willemcvu/gCAN-gauge/README.md

# gCAN-gauge
An open-source ESP32-based programmable digital gauge targeted at EV conversions

See some previews of mechanical stuff and BOM costing here: https://imgur.com/gallery/dh8G9dV/comment/2116424201
