willemcvu/gCAN-gauge/hardware/enclosure/Back Enclosure.stl

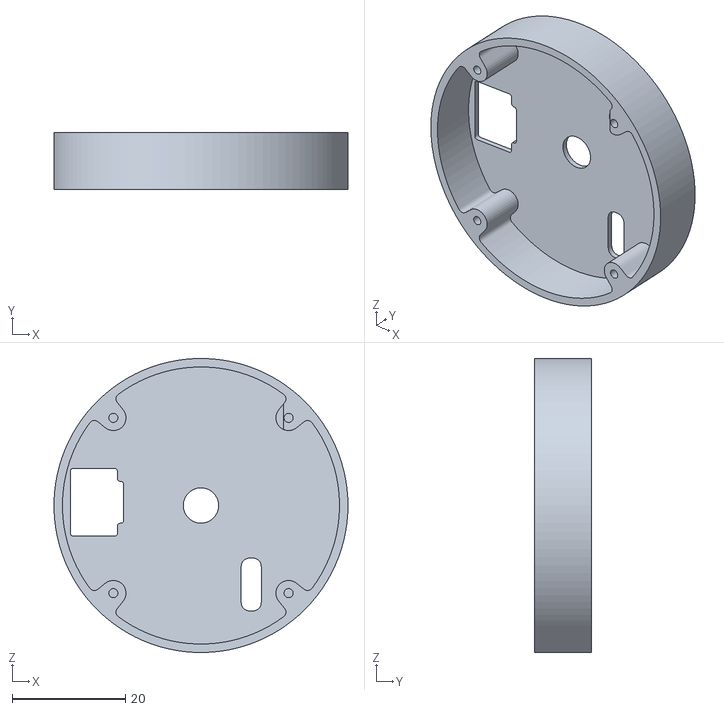
[picture p1: CAD file, 2021-08-13]
hardware/enclosure/Back Enclosure.stl
52.0 x 10.0 x 52.0
