willemcvu/gCAN-gauge/hardware/main-board/3d_models/PTS810SJS250SMTRLFS.stp

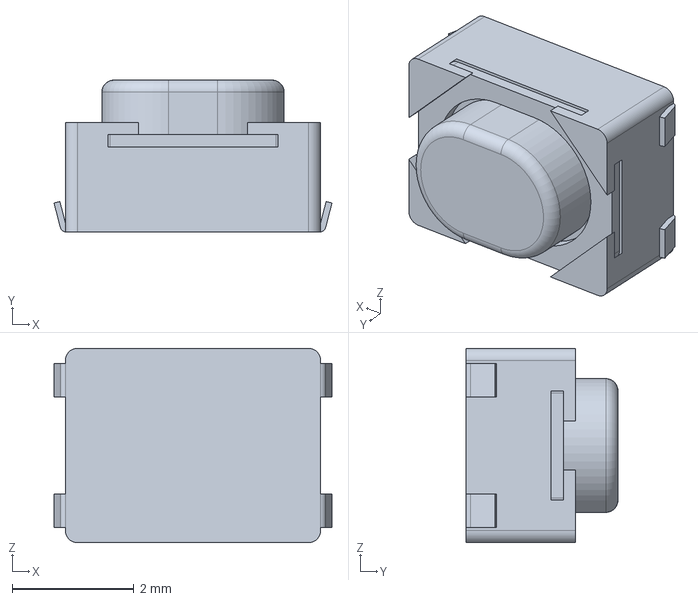
[picture p2: CAD file, 2021-08-01]
hardware/main-board/3d_models/PTS810SJS250SMTRLFS.stp
4.58 x 2.50 x 3.20 mm
