willemcvu/gCAN-gauge/hardware/enclosure/Front Enclosure.stl

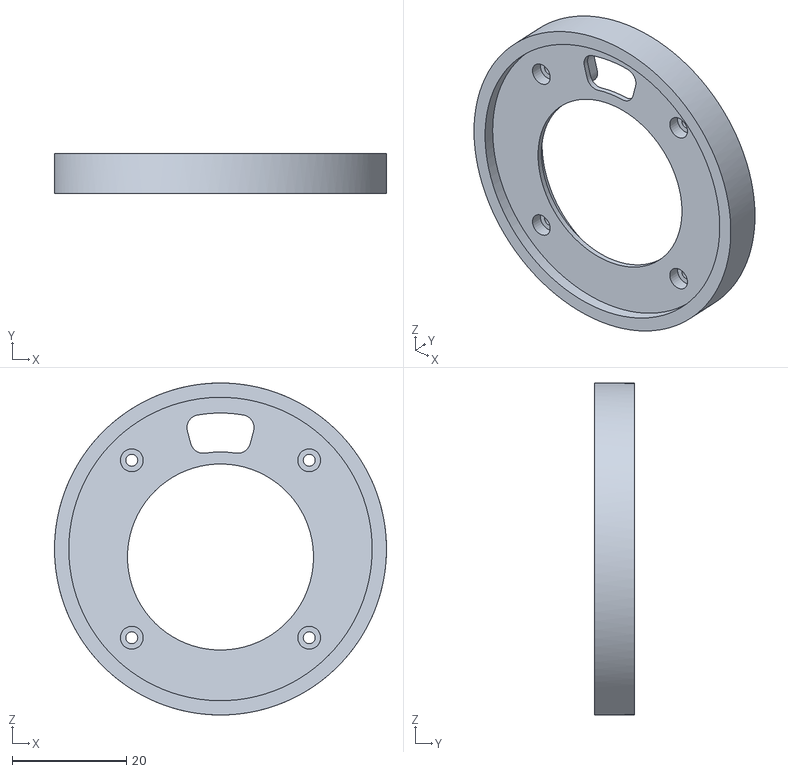
[picture p3: CAD file, 2021-08-13]
hardware/enclosure/Front Enclosure.stl
58.0 x 7.00 x 58.0
