willemcvu/gCAN-gauge/hardware/main-board/3d_models/B3S_110[].step

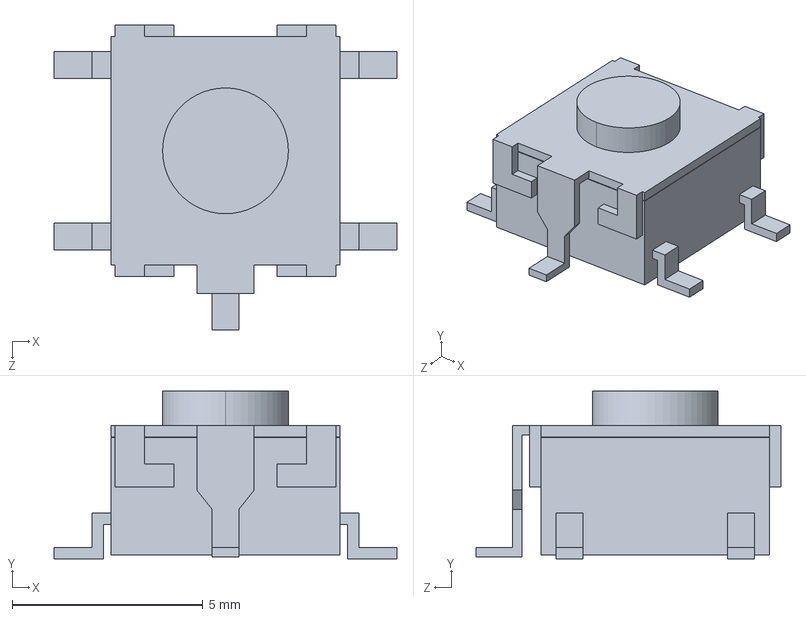
[picture p4: CAD file, 2021-08-01]
hardware/main-board/3d_models/B3S_110[].step
9.00 x 4.40 x 8.00 mm
