willemcvu/gCAN-gauge/hardware/enclosure/Front button.stl

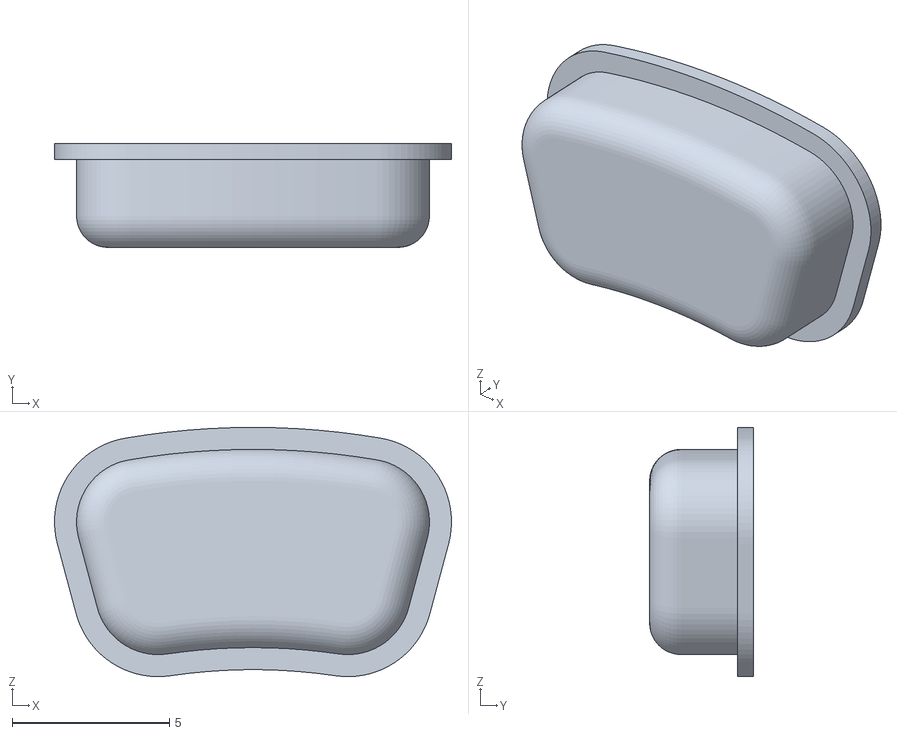
[picture p5: CAD file, 2021-08-13]
hardware/enclosure/Front button.stl
12.6 x 3.30 x 7.92
