willemcvu/gCAN-gauge/hardware/main-board/3d_models/SOP-8L_DIO.step

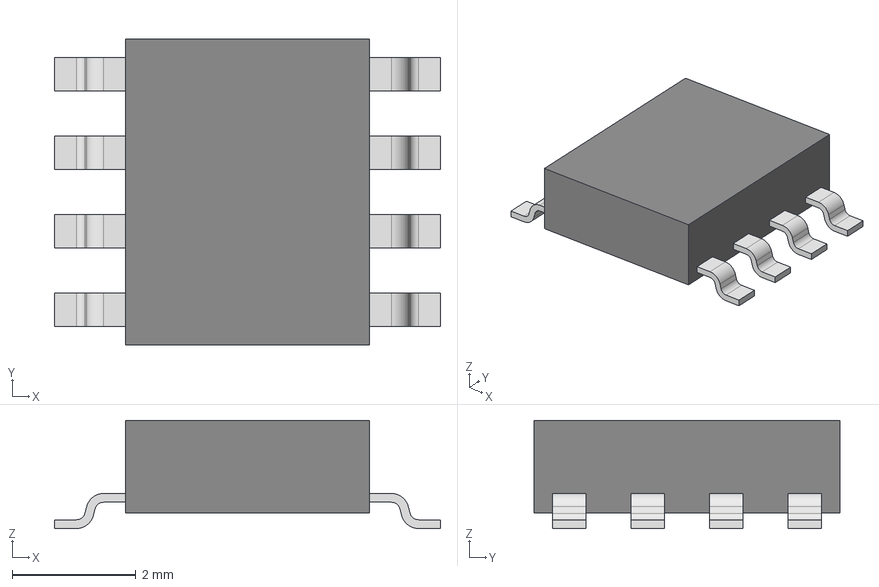
[picture p6: CAD file, 2021-07-31]
hardware/main-board/3d_models/SOP-8L_DIO.step
6.25 x 4.95 x 1.75 mm
