willemcvu/gCAN-gauge/hardware/main-board/3d_models/IND_TAIYO_NR6045_TAY.step

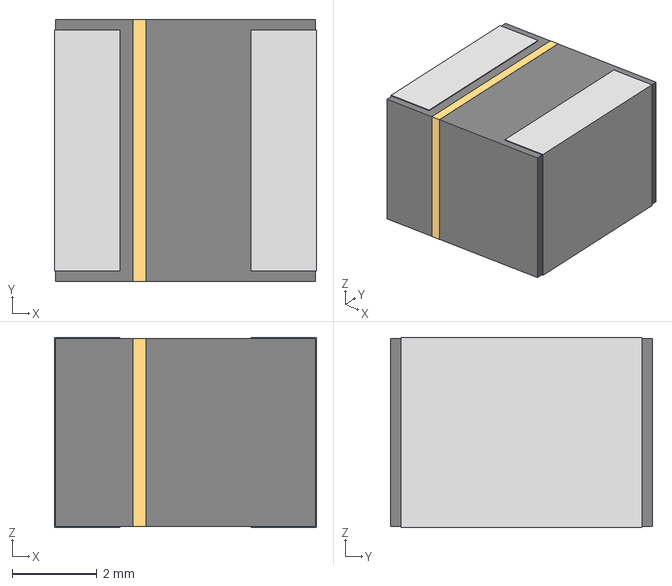
[picture p7: CAD file, 2021-07-31]
hardware/main-board/3d_models/IND_TAIYO_NR6045_TAY.step
6.20 x 6.20 x 4.50 mm
