willemcvu/gCAN-gauge/hardware/main-board/3d_models/B04B-JWPF-SK-R.STEP

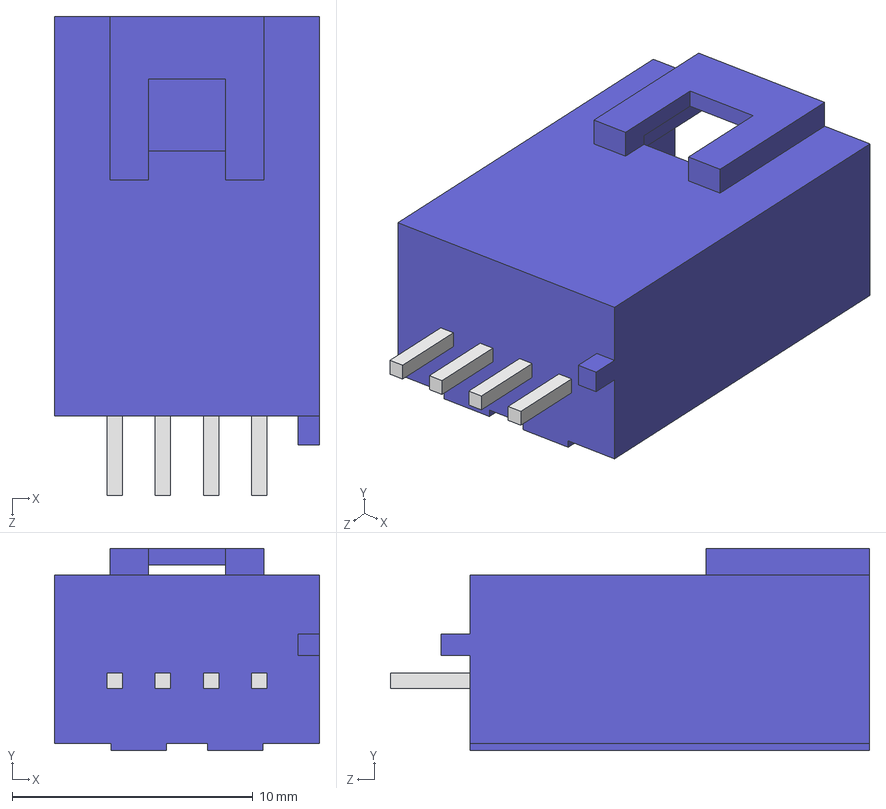
[picture p8: CAD file, 2021-07-31]
hardware/main-board/3d_models/B04B-JWPF-SK-R.STEP
11.0 x 8.40 x 19.9 mm
