willemcvu/gCAN-gauge/hardware/main-board/3d_models/K3D-DX07S024WJ3-V2_JAE_Proprietary.STEP

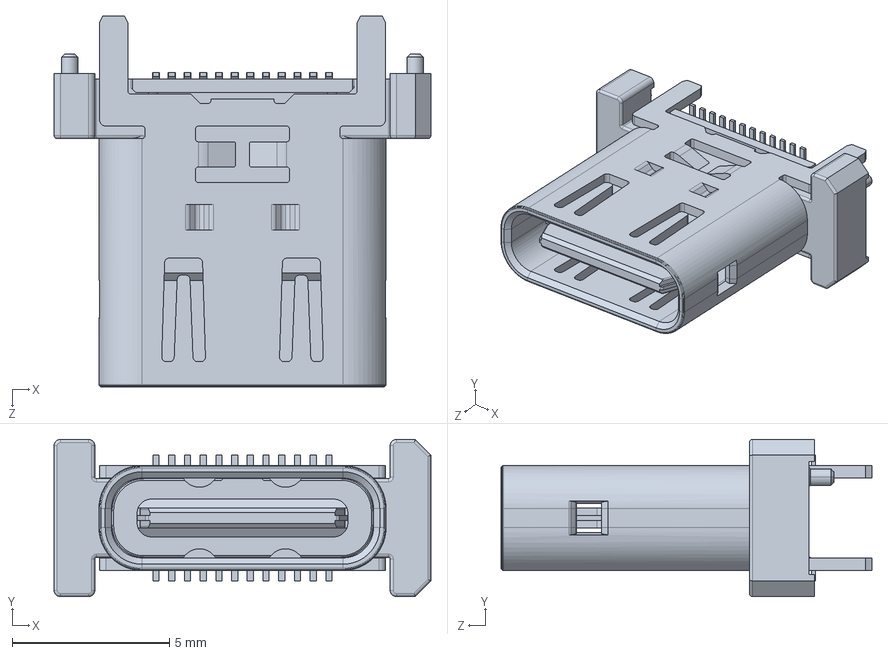
[picture p9: CAD file, 2021-07-31]
hardware/main-board/3d_models/K3D-DX07S024WJ3-V2_JAE_Proprietary.STEP
12.0 x 5.00 x 11.8 mm
