willemcvu/gCAN-gauge/hardware/main-board/3d_models/dr331.stp

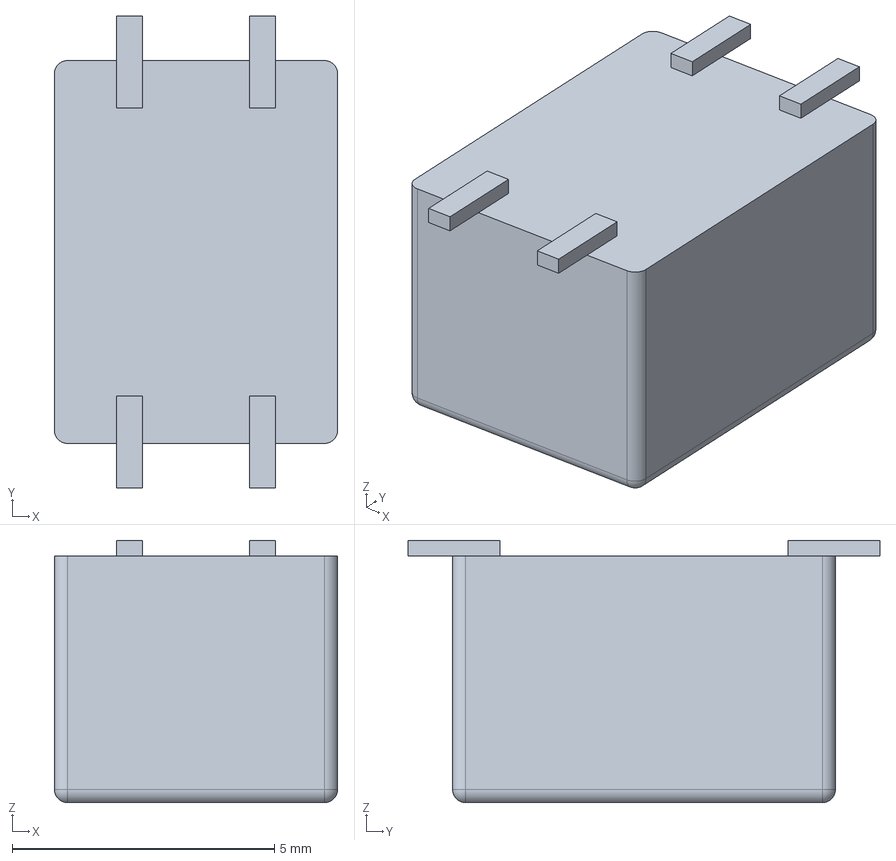
[picture p10: CAD file, 2021-07-23]
hardware/main-board/3d_models/dr331.stp
5.40 x 9.00 x 5.00 mm
