willemcvu/gCAN-gauge/(list of files, cad)

Other CAD files:
hardware/enclosure/gcan-gauge v31.f3z
