willemcvu/gCAN-gauge/hardware/main-board/main-board.kicad_pcb

## KiCad design hardware/main-board/main-board.kicad_pcb (2021-08-06)

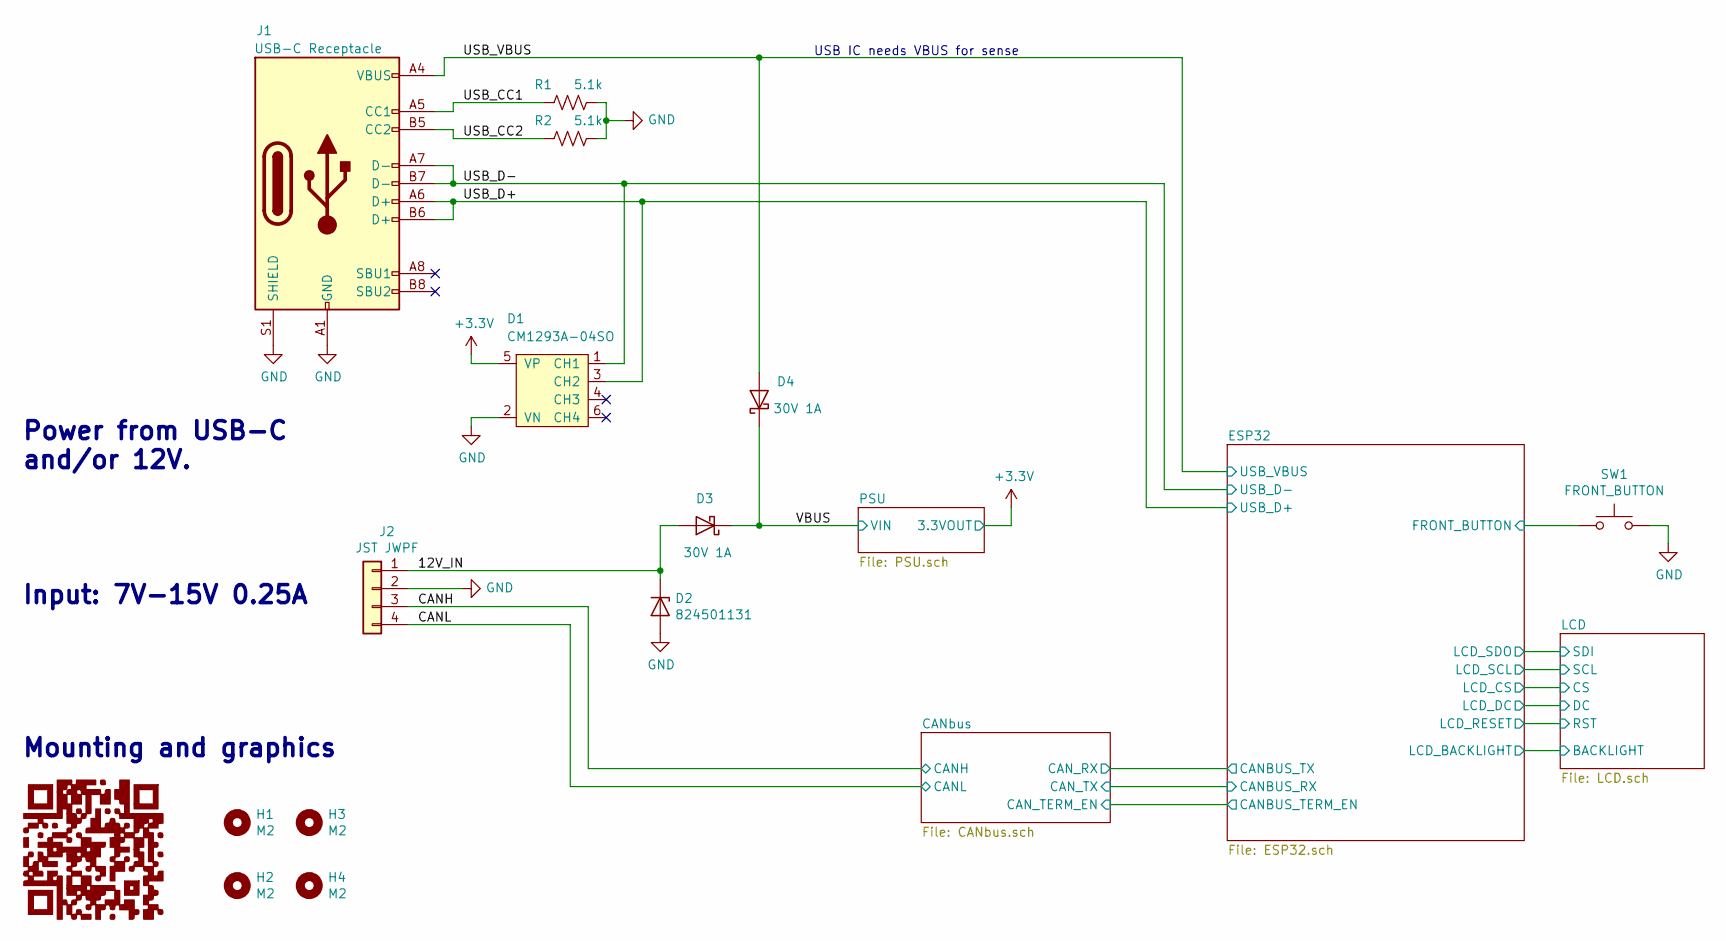
[picture p11: schematic main-board.sch]

Parts:
D1: CM1293A-04SO; SOT-23-6; MPN CM1293A-04SO
D2: 824501131; D_SMA; MPN 824501131
D3, D4: 30V 1A; D_SMA; MPN SS13MHRSG
G1: LOGO; gcan-gauge-github-link-qr; MPN DNP
H1, H2, H3, H4: M2; MountingHole_2.1mm; MPN DNP
J1: USB-C Receptacle; USB_C_Receptacle_JAE_DX07S024WJ3R400; MPN DX07S024WJ3R400
J2: JST JWPF; JST_JWPF_B04B-JWPF-SK-R_1x04_P2.00mm_Vertical; MPN B04B-JWPF-SK-R(LF)(SN)
R1, R2: 5.1k; R_0603_1608Metric; MPN RC0603JR-075K1L
SW1: FRONT_BUTTON; SW_SPST_PTS810; MPN B3S-1100P

Connections:
+3V3: D1.5 (VP); also elsewhere on the board
/12V_IN: D2.1 (K), D3.2 (A), J2.1
/CANH: J2.3; also elsewhere on the board
/CANL: J2.4; also elsewhere on the board
/ESP32/FRONT_BUTTON: SW1.1; also elsewhere on the board
/USB_CC1: J1.A5 (CC1), R1.2
/USB_CC2: J1.B5 (CC2), R2.2
/USB_D+: D1.3 (CH2), J1.A6 (D+), J1.B6 (D+); also elsewhere on the board
/USB_D-: D1.1 (CH1), J1.A7 (D-), J1.B7 (D-); also elsewhere on the board
/USB_VBUS: D4.2 (A), J1.A4 (VBUS), J1.A9 (VBUS), J1.B4 (VBUS), J1.B9 (VBUS); also elsewhere on the board
/VBUS: D3.1 (K), D4.1 (K); also elsewhere on the board
GND: D1.2 (VN), D2.2 (A), J1.A1 (GND), J1.A12 (GND), J1.B1 (GND), J1.B12 (GND), J1.S1 (SHIELD), J2.2, R1.1, R2.1, SW1.2; also elsewhere on the board

Notes on the sheet:
Input: 7V-15V 0.25A
Power from USB-C and/or 12V.
Mounting and graphics
USB IC needs VBUS for sense

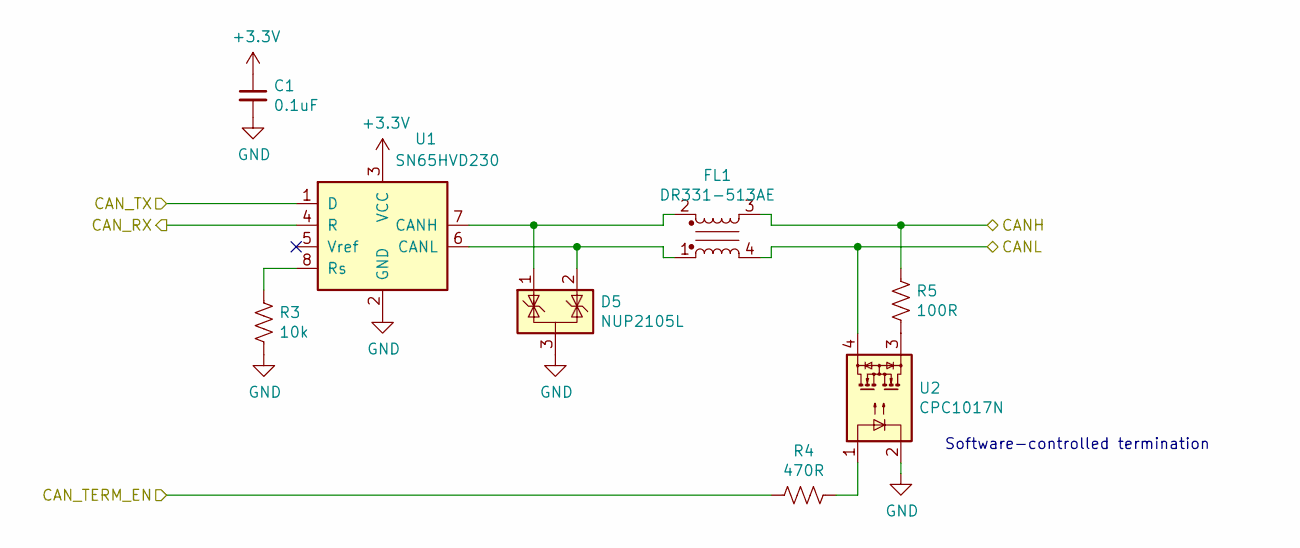
[picture p12: schematic CANbus.sch]

Parts:
C1: 0.1uF; C_0603_1608Metric; MPN CL10B104KA8NFNC
D5: NUP2105L; SOT-23; MPN NUP2105LT1G
FL1: DR331-513AE; COMMON_MODE_CHOKE_BOURNS_DR331; MPN DR331-513AE
R3: 10k; R_0603_1608Metric; MPN RC0603JR-0710KL
R4: 470R; R_0603_1608Metric; MPN RC0603JR-07470RL
R5: 100R; R_0603_1608Metric; MPN RC0603JR-07100RL
U1: SN65HVD230; SOIC-8_3.9x4.9mm_P1.27mm; MPN SN65HVD230
U2: CPC1017N; SOP-4_3.8x4.1mm_P2.54mm; MPN CPC1017N

Connections:
+3V3: C1.1, U1.3 (VCC); also elsewhere on the board
/CANH: FL1.3, R5.1; also elsewhere on the board
/CANL: FL1.4, U2.4; also elsewhere on the board
/ESP32/CANBUS_RX: U1.1 (D); also elsewhere on the board
/ESP32/CANBUS_TERM_EN: R4.2; also elsewhere on the board
/ESP32/CANBUS_TX: U1.4 (R); also elsewhere on the board
GND: C1.2, D5.3 (A), R3.2, U1.2 (GND), U2.2; also elsewhere on the board
unnamed: D5.1 (K), FL1.2, U1.7 (CANH)
unnamed: D5.2 (K), FL1.1, U1.6 (CANL)
unnamed: R3.1, U1.8 (Rs)
unnamed: R4.1, U2.1
unnamed: R5.2, U2.3

Notes on the sheet:
Software-controlled termination

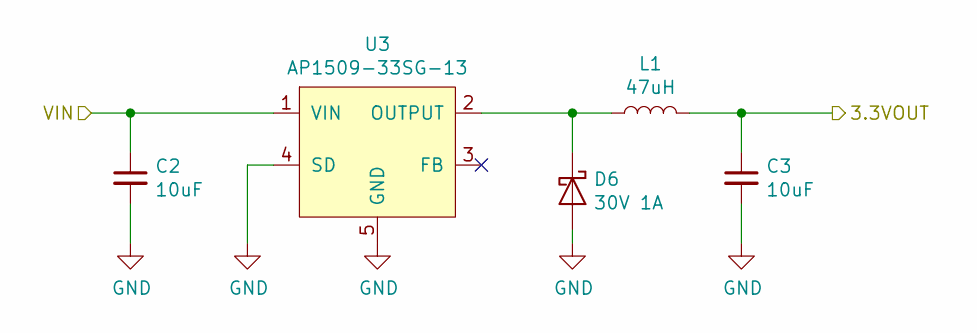
[picture p13: schematic PSU.sch]

Parts:
C2: 10uF; C_1210_3225Metric; MPN C1210C106M3RACTU
C3: 10uF; C_0805_2012Metric; MPN CL21B106KQQNFNE
D6: 30V 1A; D_SMA; MPN SS13MHRSG
L1: 47uH; L_Taiyo-Yuden_NR-60xx; MPN NRS6045T470MMGKV
U3: AP1509-33SG-13; SO-8_3.9x4.9mm_P1.27mm; MPN AP1509-33SG-13

Connections:
+3V3: C3.1, L1.2; also elsewhere on the board
/VBUS: C2.1, U3.1 (VIN); also elsewhere on the board
GND: C2.2, C3.2, D6.2 (A), U3.4 (SD), U3.5 (GND), U3.6 (GND), U3.7 (GND), U3.8 (GND); also elsewhere on the board
unnamed: D6.1 (K), L1.1, U3.2 (OUTPUT)

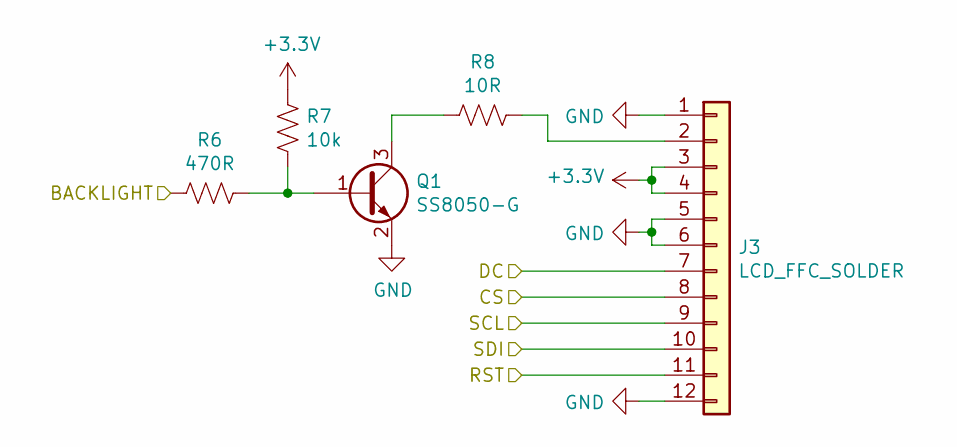
[picture p14: schematic LCD.sch]

Parts:
J3: LCD_FFC_SOLDER; LCD_ROUND_IPS_ER-TFT1.28-1; MPN DNP
Q1: SS8050-G; SOT-23; MPN SS8050-G
R6: 470R; R_0603_1608Metric; MPN RC0603JR-07470RL
R7: 10k; R_0603_1608Metric; MPN RC0603JR-0710KL
R8: 10R; R_0603_1608Metric; MPN RC0603JR-0710RL

Connections:
+3V3: J3.3, J3.4, R7.2; also elsewhere on the board
/ESP32/LCD_RESET: J3.11; also elsewhere on the board
/ESP32/LCD_SCL: J3.9; also elsewhere on the board
/ESP32/LCD_SDO: J3.10; also elsewhere on the board
/LCD/BACKLIGHT: R6.2; also elsewhere on the board
/LCD/CS: J3.8; also elsewhere on the board
/LCD/DC: J3.7; also elsewhere on the board
GND: J3.1, J3.5, J3.6, J3.12, Q1.2 (E); also elsewhere on the board
unnamed: J3.2, R8.1
unnamed: Q1.1 (B), R6.1, R7.1
unnamed: Q1.3 (C), R8.2

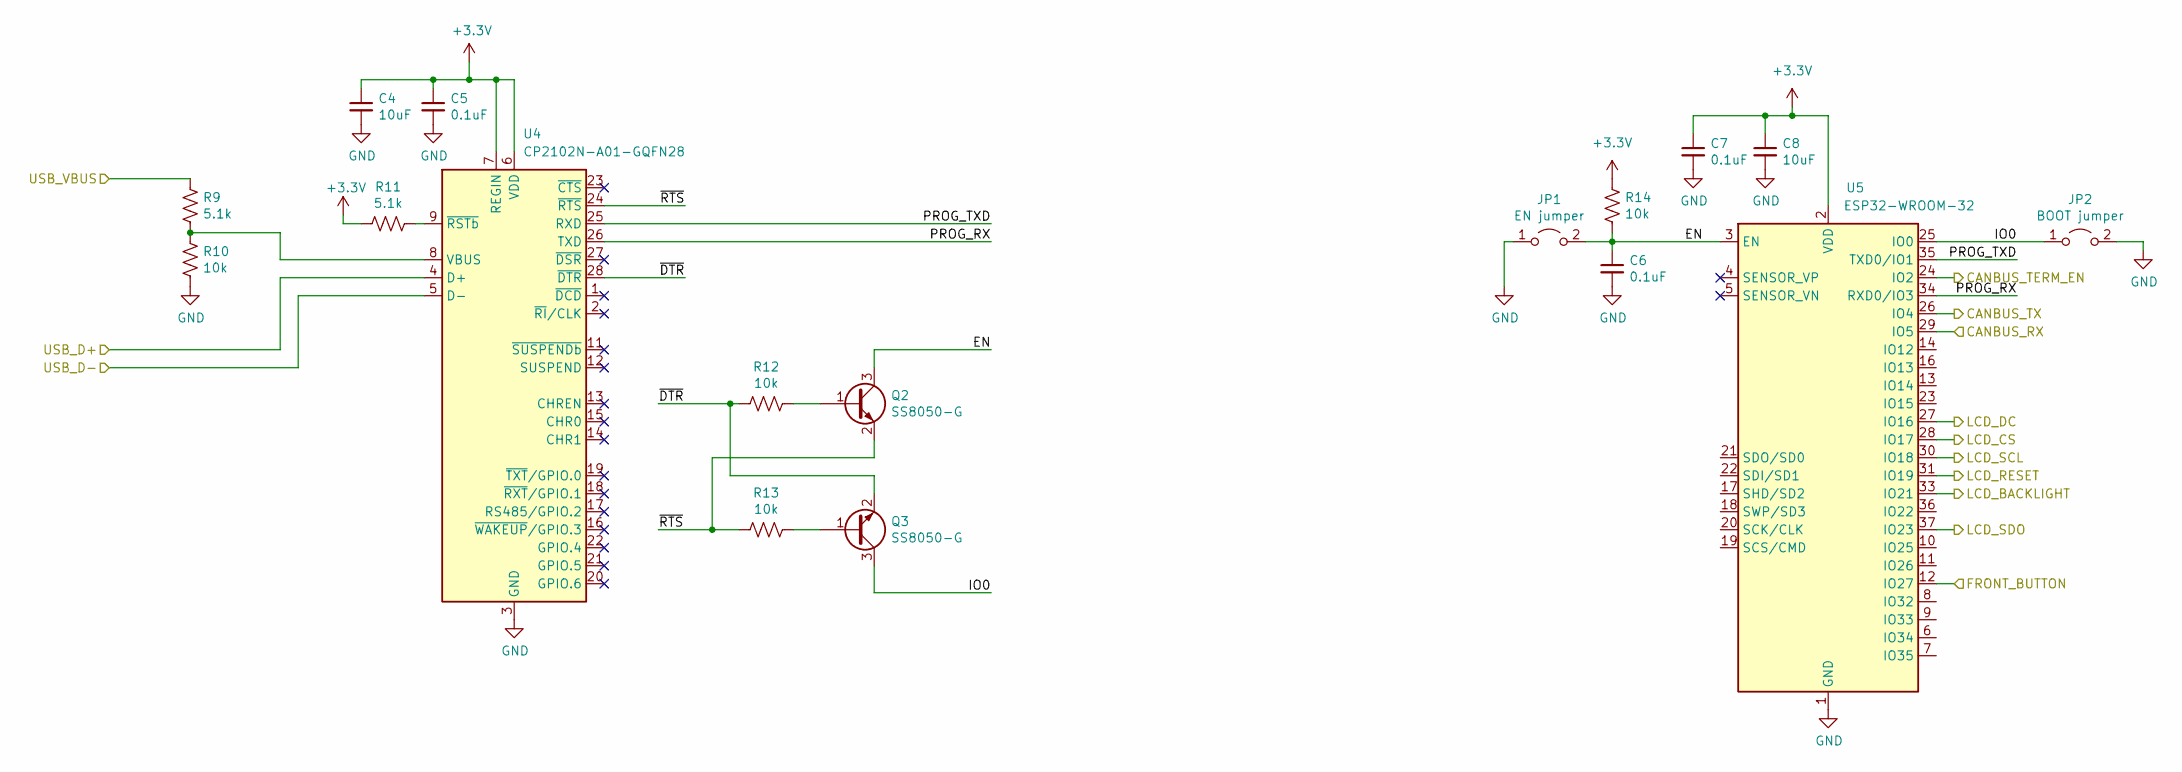
[picture p15: schematic ESP32.sch]

Parts:
C4, C8: 10uF; C_0805_2012Metric; MPN CL21B106KQQNFNE
C5, C6, C7: 0.1uF; C_0603_1608Metric; MPN CL10B104KA8NFNC
JP1: EN jumper; SolderJumper-2_P1.3mm_Open_RoundedPad1.0x1.5mm; MPN DNP
JP2: BOOT jumper; SolderJumper-2_P1.3mm_Open_RoundedPad1.0x1.5mm; MPN DNP
Q2, Q3: SS8050-G; SOT-23; MPN SS8050-G
R9, R11: 5.1k; R_0603_1608Metric; MPN RC0603JR-075K1L
R10, R12, R13, R14: 10k; R_0603_1608Metric; MPN RC0603JR-0710KL
U4: CP2102N-A01-GQFN28; QFN-28-1EP_5x5mm_P0.5mm_EP3.35x3.35mm; MPN CP2102N-A01-GQFN28
U5: ESP32-WROOM-32; MPN ESP32-WROOM-32D

Connections:
+3V3: C4.1, C5.1, C7.1, C8.1, R11.2, R14.1, U4.6 (VDD), U4.7 (REGIN), U5.2 (VDD); also elsewhere on the board
/ESP32/CANBUS_RX: U5.29 (IO5); also elsewhere on the board
/ESP32/CANBUS_TERM_EN: U5.24 (IO2); also elsewhere on the board
/ESP32/CANBUS_TX: U5.26 (IO4); also elsewhere on the board
/ESP32/EN: C6.1, JP1.2 (B), Q2.3 (C), R14.2, U5.3 (EN)
/ESP32/FRONT_BUTTON: U5.12 (IO27); also elsewhere on the board
/ESP32/IO0: JP2.1 (A), Q3.3 (C), U5.25 (IO0)
/ESP32/LCD_RESET: U5.31 (IO19); also elsewhere on the board
/ESP32/LCD_SCL: U5.30 (IO18); also elsewhere on the board
/ESP32/LCD_SDO: U5.37 (IO23); also elsewhere on the board
/ESP32/PROG_RX: U4.26 (TXD), U5.34 (RXD0/IO3)
/ESP32/PROG_TXD: U4.25 (RXD), U5.35 (TXD0/IO1)
/ESP32/~DTR: Q3.2 (E), R12.2, U4.28 (~DTR)
/ESP32/~RTS: Q2.2 (E), R13.2, U4.24 (~RTS)
/LCD/BACKLIGHT: U5.33 (IO21); also elsewhere on the board
/LCD/CS: U5.28 (IO17); also elsewhere on the board
/LCD/DC: U5.27 (IO16); also elsewhere on the board
/USB_D+: U4.4 (D+); also elsewhere on the board
/USB_D-: U4.5 (D-); also elsewhere on the board
/USB_VBUS: R9.2; also elsewhere on the board
GND: C4.2, C5.2, C6.2, C7.2, C8.2, JP1.1 (A), JP2.2 (B), R10.1, U4.3 (GND), U4.29 (GND), U5.1 (GND), U5.15 (GND), U5.38 (GND); also elsewhere on the board
unnamed: Q2.1 (B), R12.1
unnamed: Q3.1 (B), R13.1
unnamed: R9.1, R10.2, U4.8 (VBUS)
unnamed: R11.1, U4.9 (~RSTb)

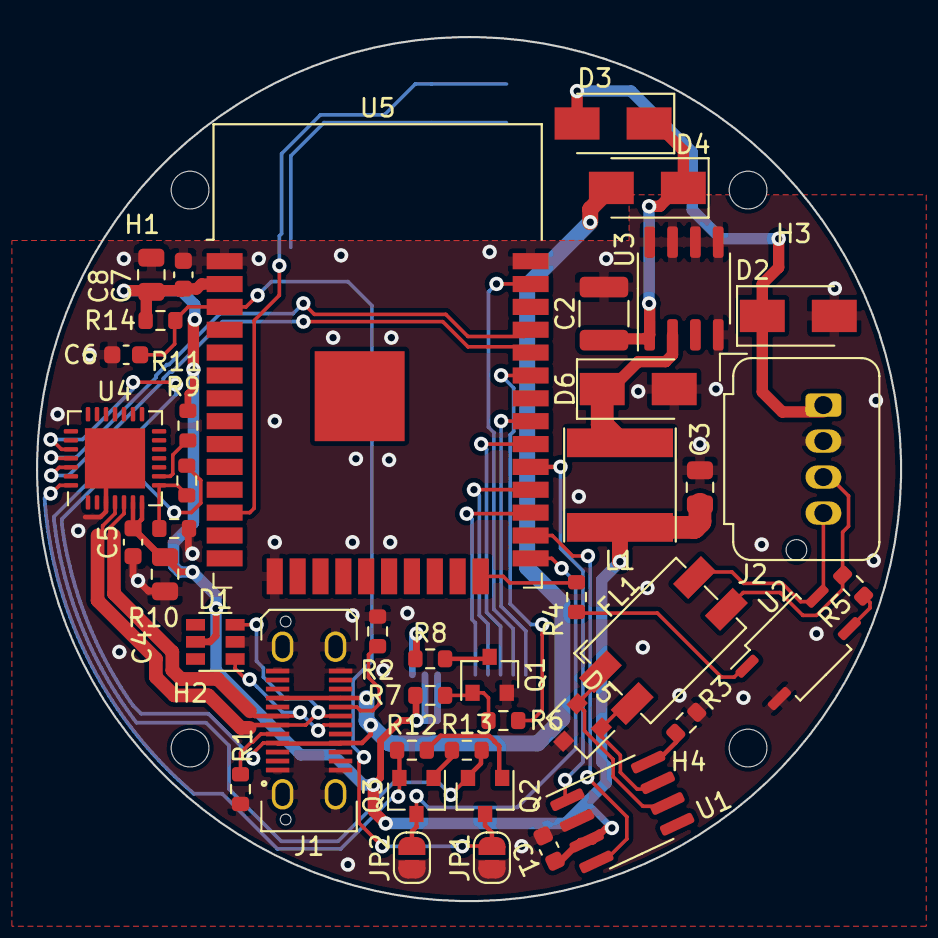
[picture p16: board main-board.kicad_pcb from above]

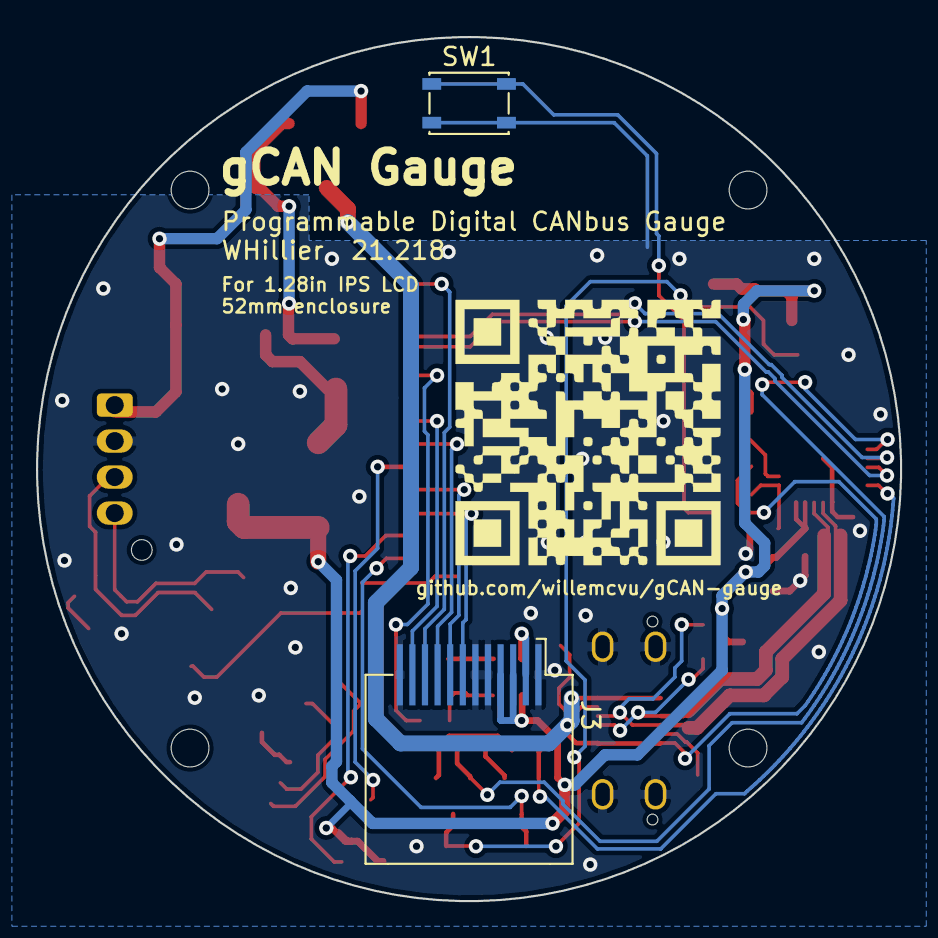
[picture p17: board main-board.kicad_pcb from below]

Board: 2 copper layers, 48.0 x 48.0 mm, 49 parts (3 on the bottom side), 40 nets.
