willemcvu/gCAN-gauge/software/testing/lcd/lcd-test/captiveportal.ino

void doWiFiManager(){
  // is auto timeout portal running
  if(portalRunning){
    wm.process(); // do processing

    // check for timeout
    if((millis()-startTime) > (timeout*1000)){
      Serial.println("portaltimeout");
      portalRunning = false;
      if(startAP){
        wm.stopConfigPortal();
      }
      else{
        wm.stopWebPortal();
      } 
   }
  }

  // is configuration portal requested?
  if(digitalRead(FRONT_SW) == LOW && (!portalRunning)) {
    if(startAP){
      Serial.println("Button Pressed, Starting Config Portal");
      wm.setConfigPortalBlocking(false);
      wm.startConfigPortal();
    }  
    else{
      Serial.println("Button Pressed, Starting Web Portal");
      wm.startWebPortal();
    }  
    portalRunning = true;
    startTime = millis();
  }
}
