willemcvu/gCAN-gauge/(commit log)

2021-07-20 Started basic schematic. Completed schematic for USB-C.
    [CANbus.sch, ESP32.sch, LCD.sch, PSU.sch, main-board.kicad_pcb, main-board.sch]
2021-07-20 Added USB to uart
    [ESP32.sch]
2021-07-21 sch wip
    [LCD.sch, PSU.sch]
2021-07-23 Sch mostly done, drew a few custom footprints, placement mostly done.
    [CANbus.sch, ESP32.sch, LCD.sch, PSU.sch, dr331.stp, main-board.sch]
2021-07-31 layout almost done
    [CANbus.sch, ESP32.sch, LCD.sch, PSU.sch, main-board.kicad_pcb, main-board.sch]
2021-07-31 added all 3d
    [B04B-JWPF-SK-R.STEP, IND_TAIYO_NR6045_TAY.step, K3D-DX07S024WJ3-V2_JAE_Proprietary.STEP, PSU.sch, main-board.kicad_pcb, main-board.sch]
2021-07-31 SO-8 3d added, layout done
    [PSU.sch, SOP-8L_DIO.step, main-board.kicad_pcb, main-board.sch]
2021-07-31 fixed wrong smd/tht attribute. exported STEP.
    [main-board.kicad_pcb]
2021-08-01 updated LCD to proper board footprint, added additional 3d models
    [B3S_110[].step, CANbus.sch, ESP32.sch, LCD.sch, PSU.sch, main-board.kicad_pcb, main-board.sch]
2021-08-01 added qr code, switched button to a different button. put on reddit for review
    [CANbus.sch, ESP32.sch, LCD.sch, PSU.sch, PTS810SJS250SMTRLFS.stp, main-board.kicad_pcb, main-board.sch]
2021-08-06 Added mounting holes, tweaked layout to accomodate.
    [CANbus.sch, ESP32.sch, LCD.sch, PSU.sch, main-board.kicad_pcb, main-board.sch]
2021-08-06 BOM cleanup/adding MPNs
    [CANbus.sch, ESP32.sch, LCD.sch, PSU.sch, main-board.csv, main-board.sch]
2021-08-06 further BOM fixing/cleanup for ordering.
    [CANbus.sch, ESP32.sch, main-board.csv]
2021-08-06 exported gerbers. Shipping 21.218.
    [main-board.kicad_pcb]
2021-08-13 cleaning up BOM
    [main-board.sch]
2021-08-13 first code :) currently just sweeps up and then down from 0-100. But a good first test to prove how smooth the display can be at 80MHz SPI.
2021-08-13 Enclosure parts ready to test print
    [Back Enclosure.stl, Front Enclosure.stl, Front button.stl, gcan-gauge v31.f3z]
